StuartsProjects/Relay1/Pictures/6.jpg

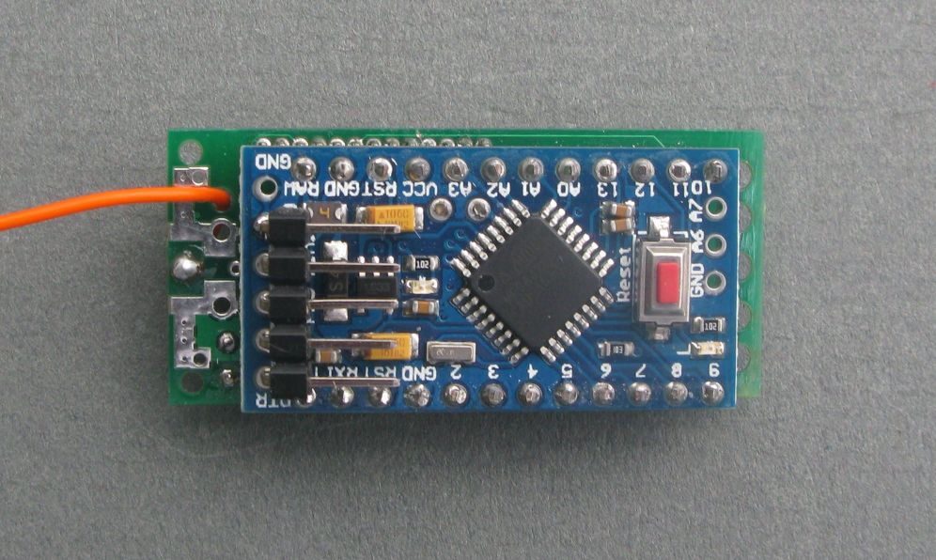
Pictures/6.jpg
