StuartsProjects/Relay1/Pictures/5.jpg

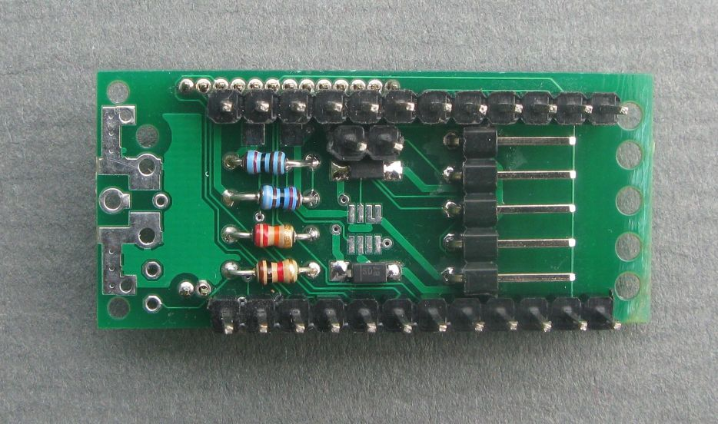
Pictures/5.jpg
