StuartsProjects/Relay1/Fitting Pin Headers to Tracker Boards.pdf

### Fitting Pin Headers to Tracker Boards

The holes for the pin headers used to fir the Arduino Pro Mini on some tracker boards are a bit tight for the normal square 0.1” pin headers. They fit just about, but it’s not easy. For this reason you may have been supplied with turned pin style pin headers which are a nice easy fit.

These pin headers should be fitted the right way around, with the domed\pointed part of the pin against the tracker PCB and the flat side against the Pro Mini. The Picture shows the turned pin headers supplied, and the correct way around to fit them.

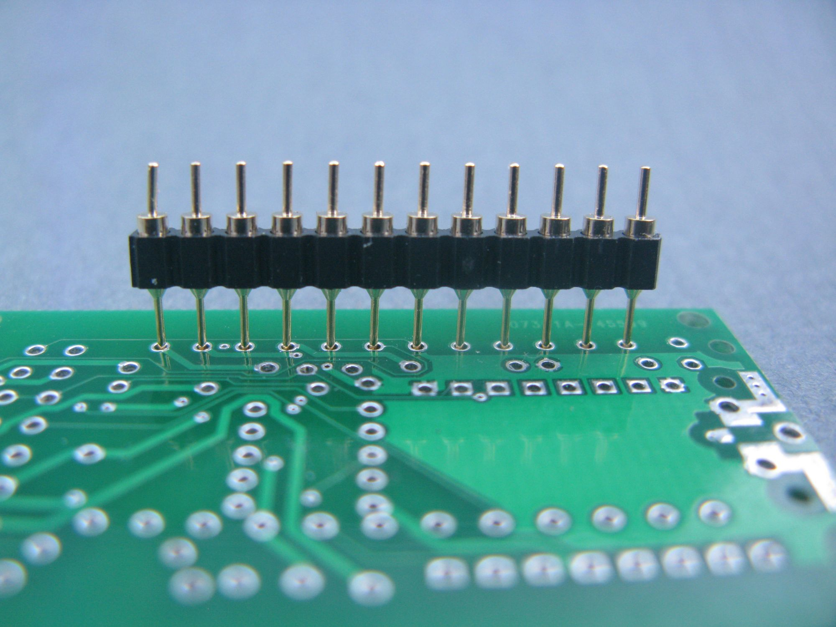
[picture p3: figure]

Stuart Robinson
GW7HPW
November 2016
