StuartsProjects/Relay1/Layouts and Schematics/LoRa DRF1278F Relay PCB.pdf

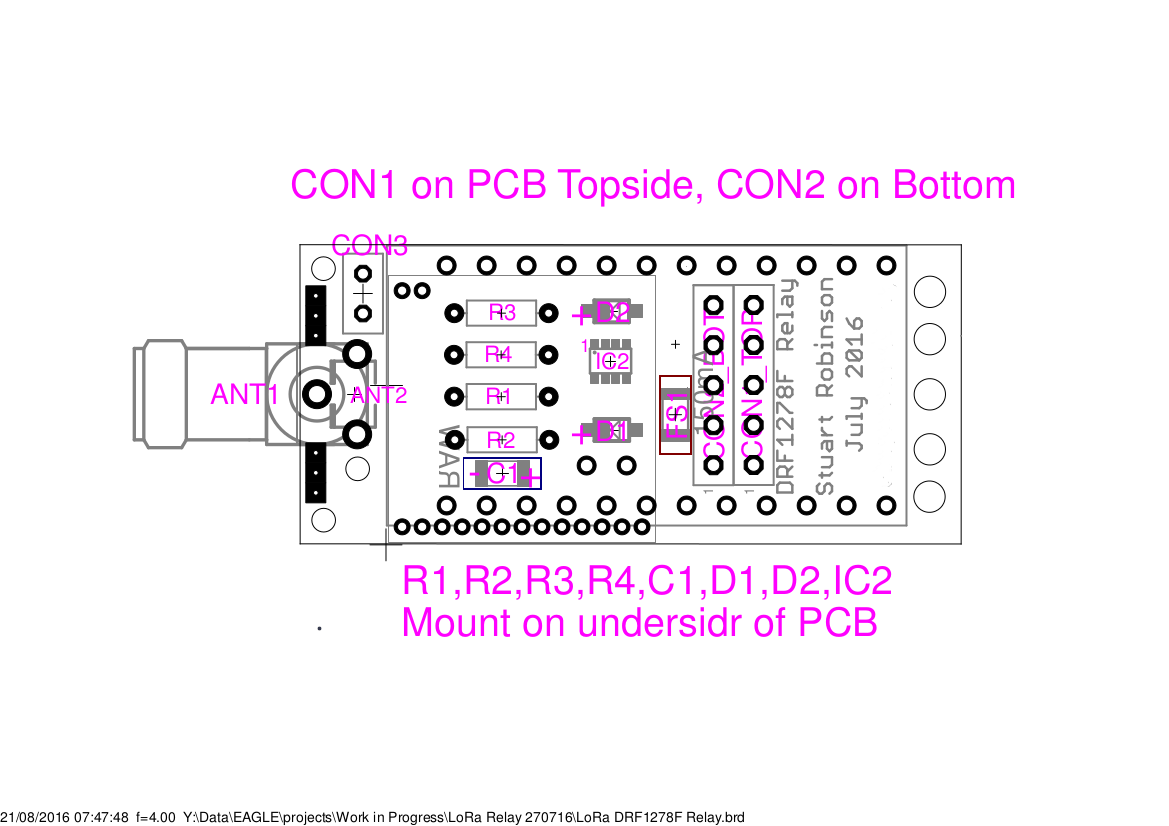
[picture p4: page 1]
