StuartsProjects/Relay1/Layouts and Schematics/LoRa DRF1278F Relay Schematic.pdf

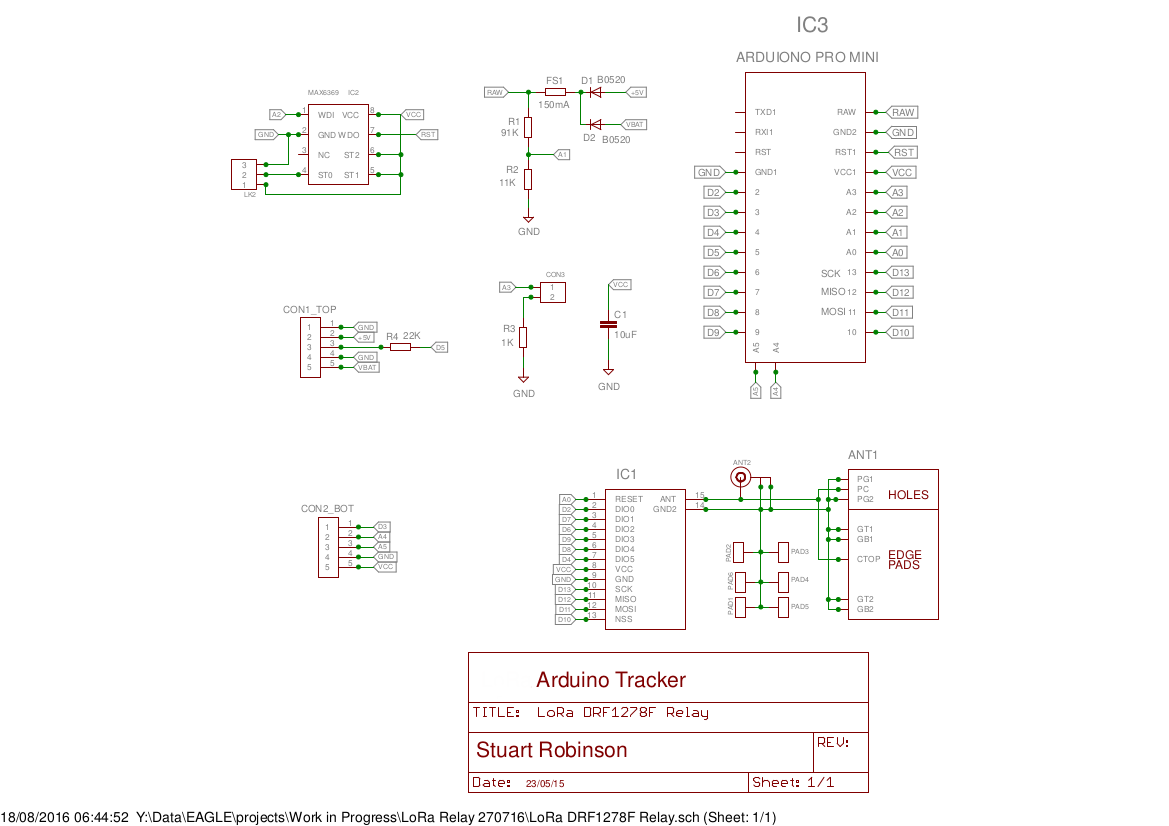
[picture p5: page 1]
