StuartsProjects/Relay1/Pictures/2.jpg

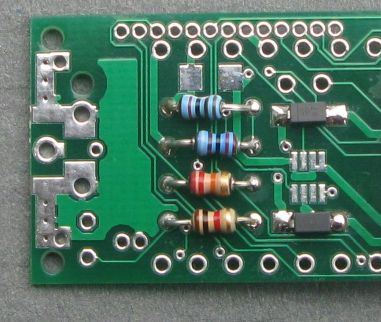
Pictures/2.jpg
