StuartsProjects/Relay1/Pictures/7.jpg

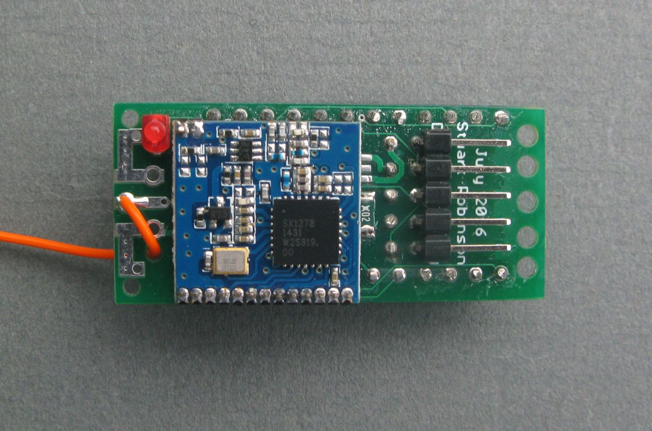
Pictures/7.jpg
