StuartsProjects/Relay1/Pictures/8.jpg

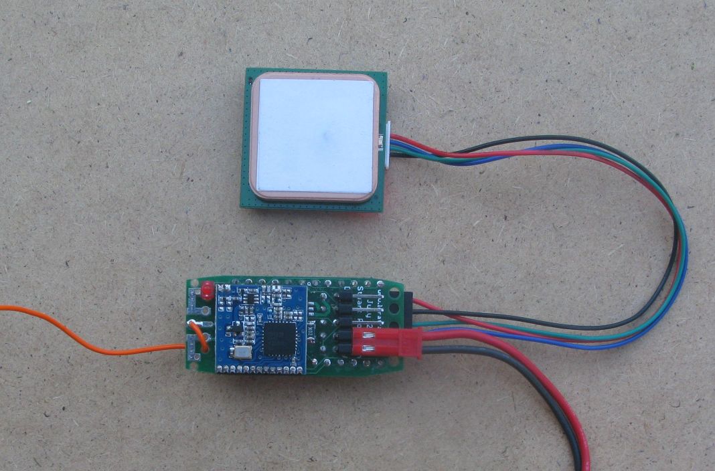
Pictures/8.jpg
