StuartsProjects/Relay1/Pictures/9.jpg

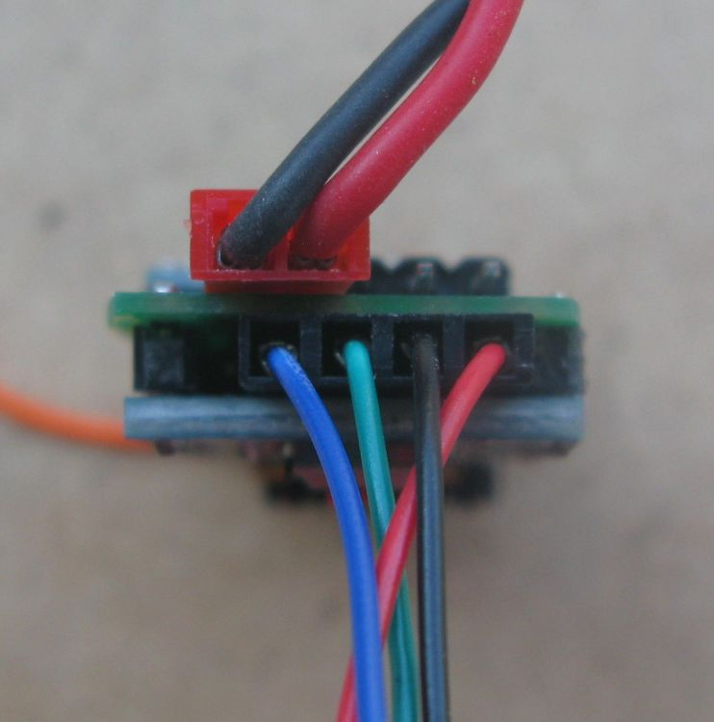
Pictures/9.jpg
