StuartsProjects/Relay1/Parts Lists/BOM LoRa DRF1278F Relay.xls

Part | Value | Package
ANT1 | CUSTOMSMA | PCB pads Only
ANT2 | ANTENNA_U.FL | U.FL
C1 | 10uF | C1206
CON1_TOP | 5 WAY 1 ROW ANGLED | 0.1”
CON2_BOT | 5 WAY 1 ROW ANGLED | 0.1”
CON3 | RED LED | 1.8mm
D1 | B0520 | SOD123
D2 | B0520 | SOD123
FS1 | 150mA Polyfuse | R1206
IC1 | DRF1278F_PINS_ONLY | 0.05” Pins
IC2 | MAX6369 | SOT8
IC3 | ARDUIONO PRO MINI | DIP
R1 | 91K 1% | 125mW RESISTOR
R2 | 11K 1% | 125mW RESISTOR
R3 | 1K | 125mW RESISTOR
R4 | 22K | 125mW RESISTOR
Extra
Pro Mini Prog | 5 WAY 1 ROW ANGLED | 0.1”
Pro Mini Mount | 12 WAY 1 ROW STRAIGHT | 0.1”
Pro Mini Mount | 12 WAY 1 ROW STRAIGHT | 0.1”
Pro Mini Mount | 2 WAY 1 ROW STRAIGHT | 0.1”
DRF1278F Mount |  | 0.05”
DRF1278F Mount | 2 WAY 1 ROW STRAIGHT
