StuartsProjects/Relay1/(commit log)

2020-08-16 Update schematic
2021-08-04 Remove pin definitions
2021-08-04 Edit pin definitions
